CyberJsec47/Arduino-HED/(commit log)

2024-09-12 Create Main.ino
    FIrst draft, displays temp and humidity to an LCD screen with an sensor turning on when somebody is close. Want sensor to turn off whole screen and backlight but currently on turns off display
2024-10-11 Create ESP32_DHT11_test
2024-10-17 Update Main.ino
    updated first station test script with wind, direction and rain sensors added and published as MQTT messages
2024-11-01 Update and rename Pressure_Live.py to Pressure.py
2024-11-15 Update Main.ino
    added light sleep mode functions for power saving
2024-11-15 Update Main.ino
    Added WDT to reset the board if reconnection timesout
    [Main.ino]
2024-11-22 Update Main.ino
    replaced WDT with a timeout to reset the board
    [Main.ino]
